aminvdb/macrokeyboard/PG151101S11.step

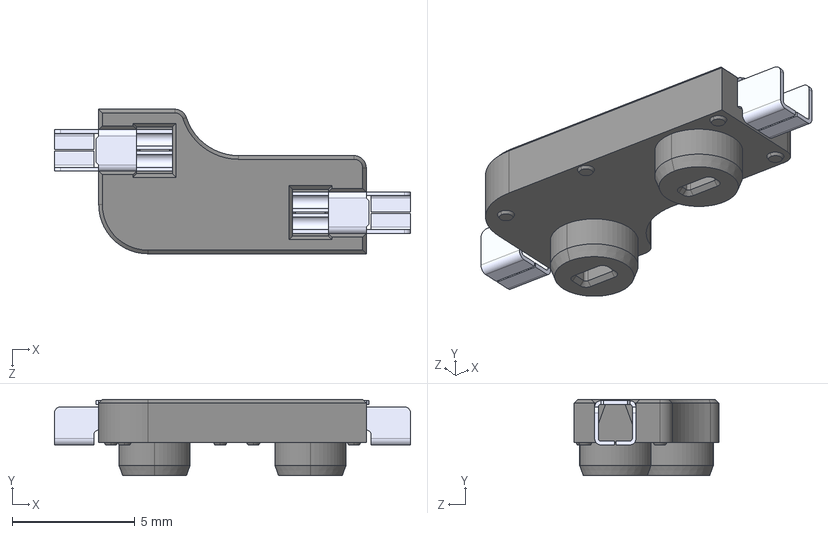
[picture p3: CAD file, 2026-05-24]
PG151101S11.step
14.5 x 3.10 x 5.89 mm
