aminvdb/macrokeyboard/keyboard.kicad_pcb

## KiCad design keyboard.kicad_pcb (2026-05-24)

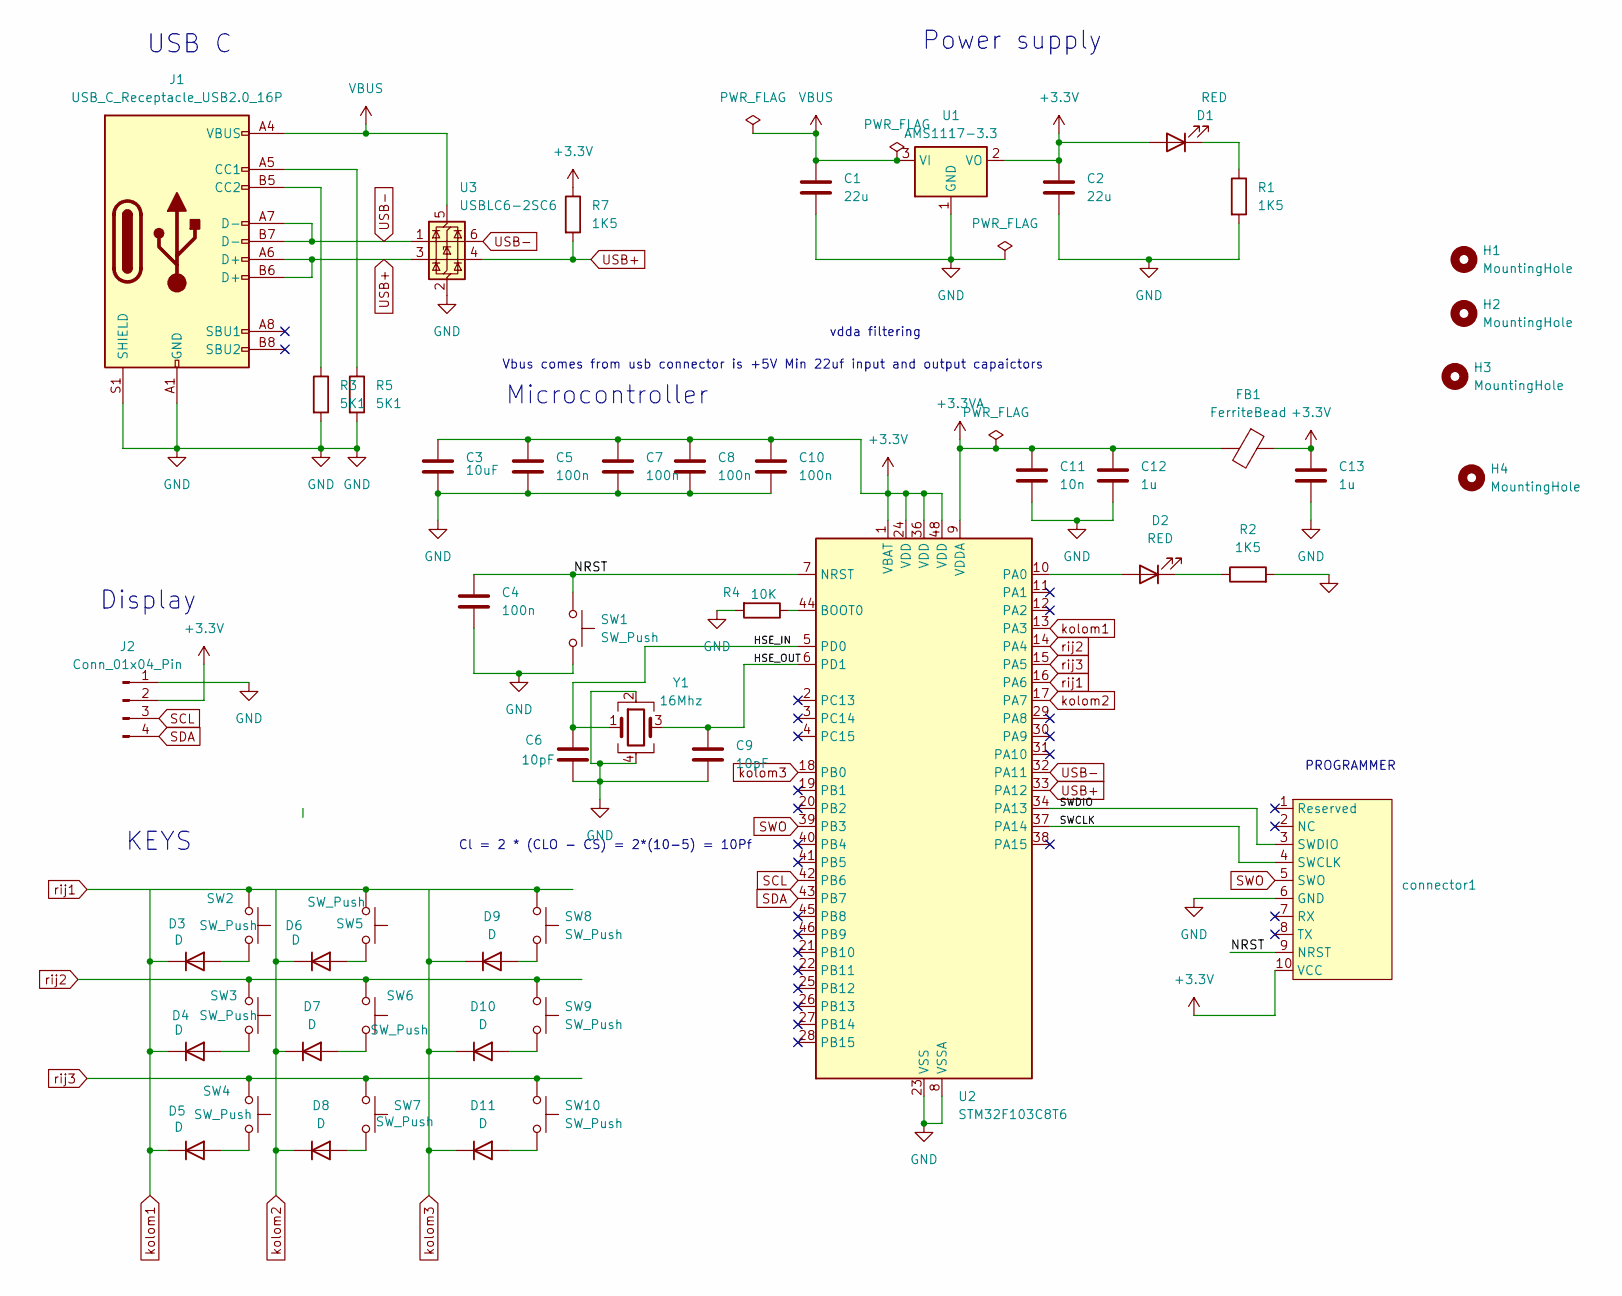
[picture p4: schematic keyboard.kicad_sch]

Parts:
C1, C2: 22u; C_0603_1608Metric
C3: 10uF; C_0603_1608Metric
C4, C5, C7, C8, C10: 100n; C_0603_1608Metric
C6, C9: 10pF; C_0603_1608Metric
C11: 10n; C_0603_1608Metric
C12, C13: 1u; C_0603_1608Metric
D1, D2: RED; LED_0603_1608Metric
D3, D4, D5, D6, D7, D8, D9, D10, D11: D; D_0603_1608Metric
FB1: FerriteBead; L_0603_1608Metric
H1, H2, H3, H4: MountingHole; MountingHole_2.1mm
J1: USB_C_Receptacle_USB2.0_16P; USB_C_Receptacle_GCT_USB4105-xx-A_16P_TopMnt_Horizontal
J2: Conn_01x04_Pin; PinHeader_1x04_P2.54mm_Vertical
R1, R2: 1K5; R_0402_1005Metric
R3, R5: 5K1; R_0603_1608Metric
R4: 10K; R_0603_1608Metric
R7: 1K5; R_0603_1608Metric
SW1: SW_Push; SW_SPST_TL3305B
SW2, SW3, SW4, SW5, SW6, SW7, SW8, SW9, SW10: SW_Push; Kailh_socket_MX
U1: AMS1117-3.3; SOT-223-3_TabPin2
U2: STM32F103C8T6; LQFP-48_7x7mm_P0.5mm
U3: USBLC6-2SC6; SOT-23-6
Y1: 16Mhz; Crystal_SMD_3225-4Pin_3.2x2.5mm
connector1: Open Ended Card Edge

Connections:
+3.3V: C2.1, C3.1, C5.1, C7.1, C8.1, C10.1, C13.1, D1.2 (A), FB1.1, J2.2, R7.1, U1.2 (VO), U2.1 (VBAT), U2.24 (VDD), U2.36 (VDD), U2.48 (VDD), connector1.10 (VCC)
+3.3VA: C11.1, C12.1, FB1.2, U2.9 (VDDA)
/HSE_IN: C6.1, U2.5 (PD0), Y1.1
/HSE_OUT: C9.1, U2.6 (PD1), Y1.3
/NRST: C4.1, SW1.1, U2.7 (NRST), connector1.9 (NRST)
/SWCLK: U2.37 (PA14), connector1.4 (SWCLK)
/SWDIO: U2.34 (PA13), connector1.3 (SWDIO)
GND: C1.2, C2.2, C3.2, C4.2, C5.2, C6.2, C7.2, C8.2, C9.2, C10.2, C11.2, C12.2, C13.2, J1.A1 (GND), J1.A12 (GND), J1.B1 (GND), J1.B12 (GND), J1.S1 (SHIELD), J2.1, R1.2, R2.2, R3.2, R4.2, R5.2, SW1.2, U1.1 (GND), U2.8 (VSSA), U2.23 (VSS), U2.35 (VSS), U2.47 (VSS), U3.2 (GND), Y1.2, Y1.4, connector1.6 (GND)
unnamed: D1.1 (K), R1.1
unnamed: D2.2 (A), U2.10 (PA0)
unnamed: D2.1 (K), R2.1
unnamed: D3.2 (A), SW2.2
unnamed: D4.2 (A), SW3.2
unnamed: D5.2 (A), SW4.2
unnamed: D6.2 (A), SW5.2
unnamed: D7.2 (A), SW6.2
unnamed: D8.2 (A), SW7.2
unnamed: D9.2 (A), SW8.2
unnamed: D10.2 (A), SW9.2
unnamed: D11.2 (A), SW10.2
unnamed: J1.A5 (CC1), R5.1
unnamed: J1.B5 (CC2), R3.1
unnamed: R4.1, U2.44 (BOOT0)
SCL: J2.3, U2.42 (PB6)
SDA: J2.4, U2.43 (PB7)
SWO: U2.39 (PB3), connector1.5 (SWO)
USB+: J1.A6 (D+), J1.B6 (D+), R7.2, U2.33 (PA12), U3.3 (I/O2), U3.4 (I/O2)
USB-: J1.A7 (D-), J1.B7 (D-), U2.32 (PA11), U3.1 (I/O1), U3.6 (I/O1)
VBUS: C1.1, J1.A4 (VBUS), J1.A9 (VBUS), J1.B4 (VBUS), J1.B9 (VBUS), U1.3 (VI), U3.5 (VBUS)
kolom1: D3.1 (K), D4.1 (K), D5.1 (K), U2.13 (PA3)
kolom2: D6.1 (K), D7.1 (K), D8.1 (K), U2.17 (PA7)
kolom3: D9.1 (K), D10.1 (K), D11.1 (K), U2.18 (PB0)
rij1: SW2.1, SW5.1, SW8.1, U2.16 (PA6)
rij2: SW3.1, SW6.1, SW9.1, U2.14 (PA4)
rij3: SW4.1, SW7.1, SW10.1, U2.15 (PA5)

Notes on the sheet:
KEYS
Power supply
Cl = 2 * (CLO - CS) = 2*(10-5) = 10Pf
vdda filtering
PROGRAMMER
USB C
Vbus comes from usb connector is +5V Min 22uf input and output capaictors
Microcontroller
Display

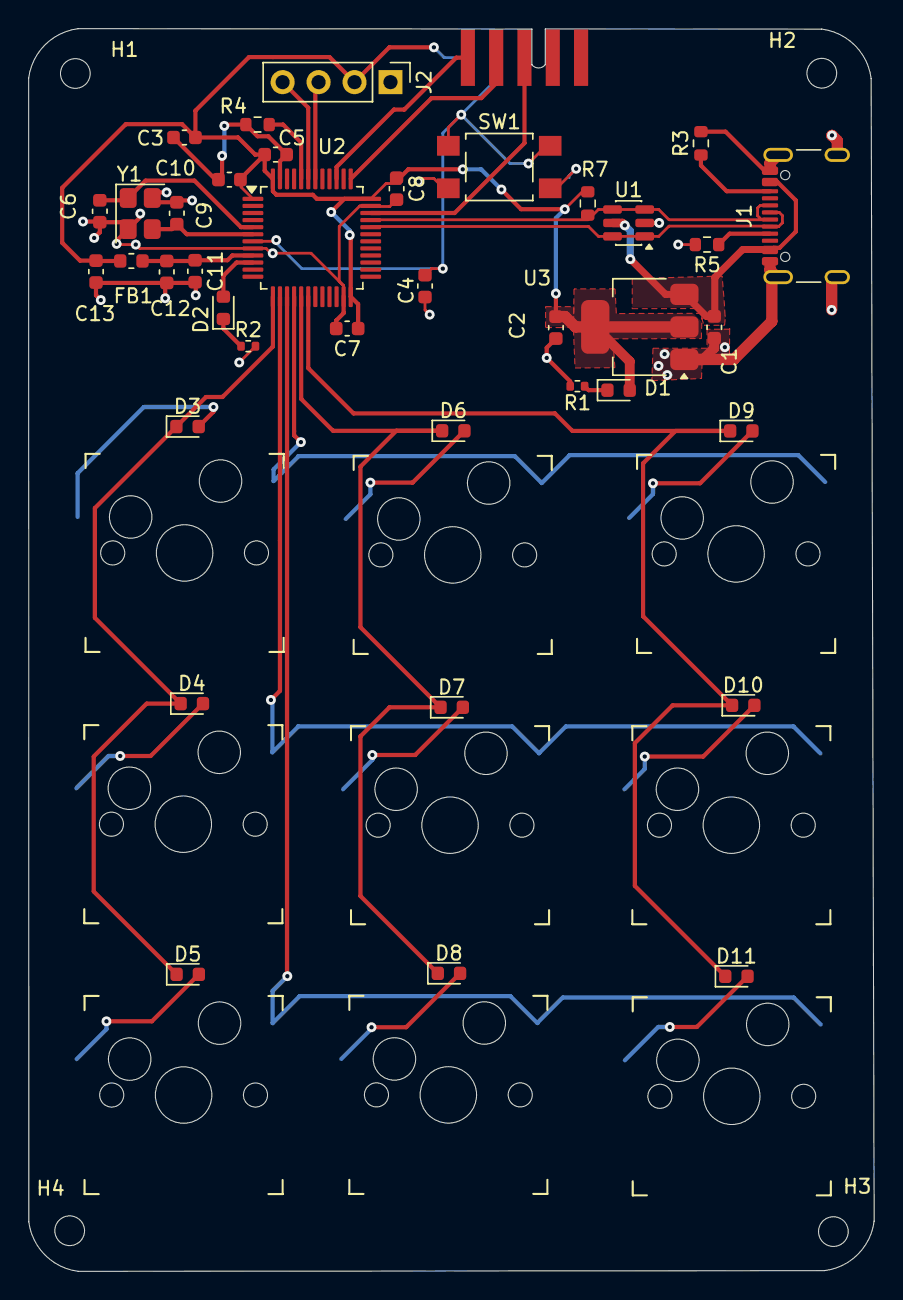
[picture p5: board keyboard.kicad_pcb from above]

Board: 2 copper layers, 59.7 x 87.8 mm, 53 parts (0 on the bottom side), 35 nets.

Other parts of the board:
H3#2: MountingHole; MountingHole_2.1mm
