aminvdb/macrokeyboard/keyboard.ioc

Mcu.UserName=STM32F103C8Tx
PA11.Signal=USB_DM
PA12.Signal=USB_DP
PA13.Signal=SYS_JTMS-SWDIO
PA14.Signal=SYS_JTCK-SWCLK
PA3.GPIO_Label=kolom1
PA3.Signal=GPIO_Output
PA4.GPIO_Label=rij2
PA4.Signal=GPIO_Input
PA5.GPIO_Label=rij3
PA5.Signal=GPIO_Input
PA6.GPIO_Label=rij1
PA6.Signal=GPIO_Input
PA7.GPIO_Label=kolom2
PA7.Signal=GPIO_Output
PB0.GPIO_Label=kolom3
PB0.Signal=GPIO_Output
PB3.Signal=SYS_JTDO-TRACESWO
PB6.Signal=I2C1_SCL
PB7.Signal=I2C1_SDA
PC14-OSC32_IN.Signal=RCC_OSC32_IN
PC15-OSC32_OUT.Signal=RCC_OSC32_OUT
PD0-OSC_IN.Signal=RCC_OSC_IN
PD1-OSC_OUT.Signal=RCC_OSC_OUT
